cristogg/TESS-W/docs/tesswpcbv1.gif

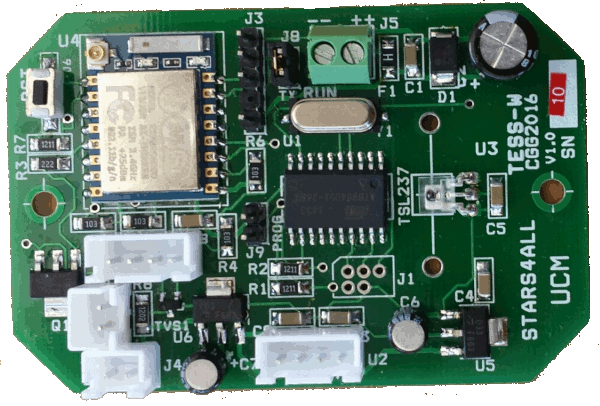
docs/tesswpcbv1.gif
