cristogg/TESS-W/docs/Tess-w_description.jpg

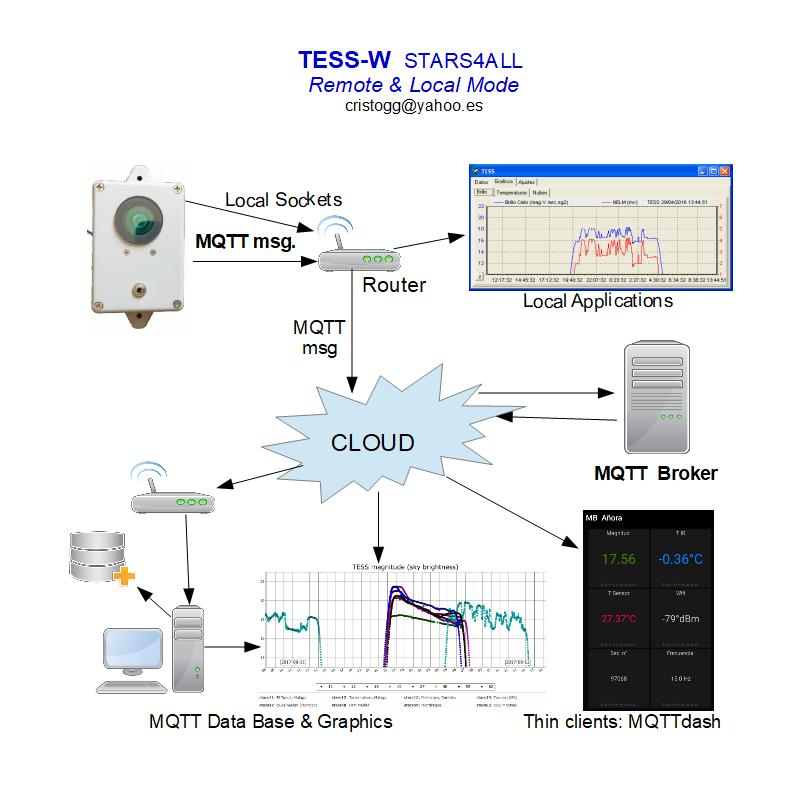
docs/Tess-w_description.jpg
