cristogg/TESS-W/upgrade/UpgradeFirmwareTessW4C.pdf

TESS-W4C Update Firmware | C. Garcia - Feb 2024

## TESS-W4C Firmware Upgrade

To update the firmware you need a micro or C type USB cable, depending on version., the .bin file and the upload program. It is necessary to open the photometer to connect the USB cable.

1- Remove the cover by unscrewing the top four screws.

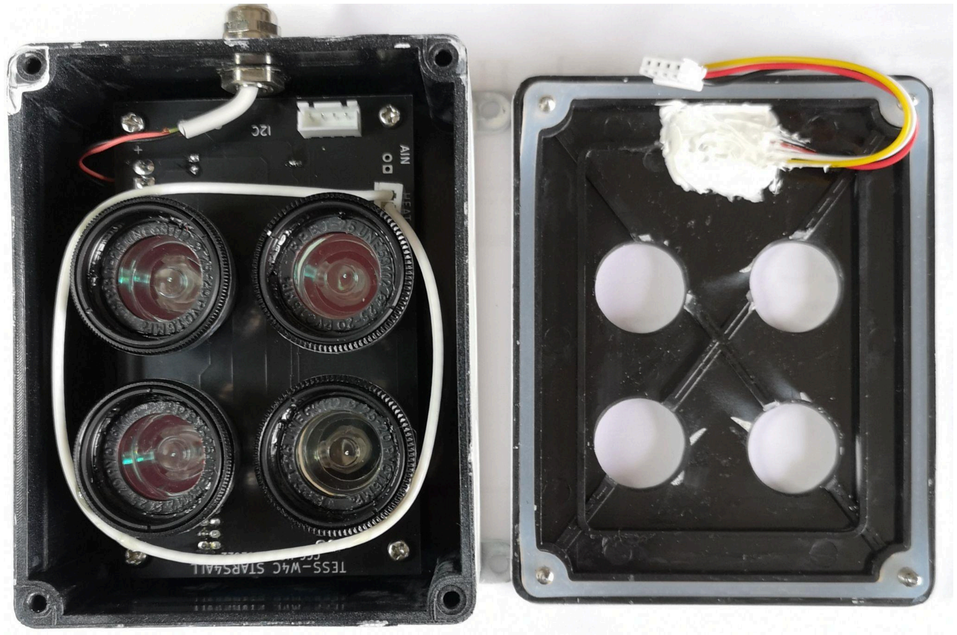
[picture p20: figure]

2- Unscrew the PCB to access the components, and connect the USB cable to the module EP32.

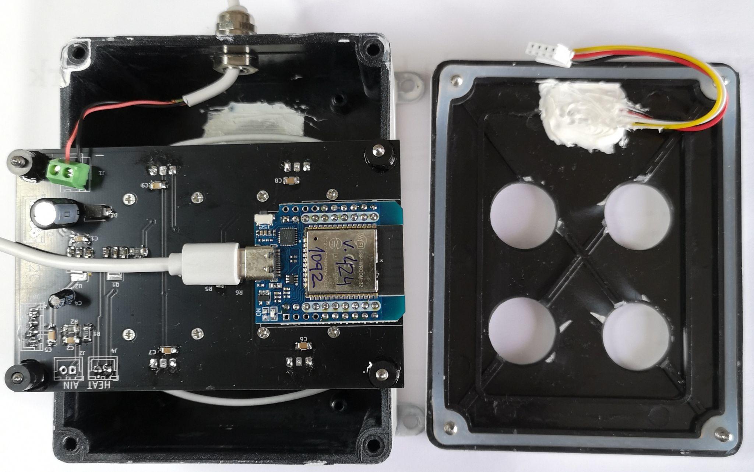
[picture p21: figure]

3- Download and unzip the update package. https://observatorioremoto.com/TessW4C_downloadtool.zip
It contains the update tool, the binary files to be loaded and a small terminal program called Termite for testing.
Before starting the update, use Termite and check how the photometer works. This test is described in the final section.

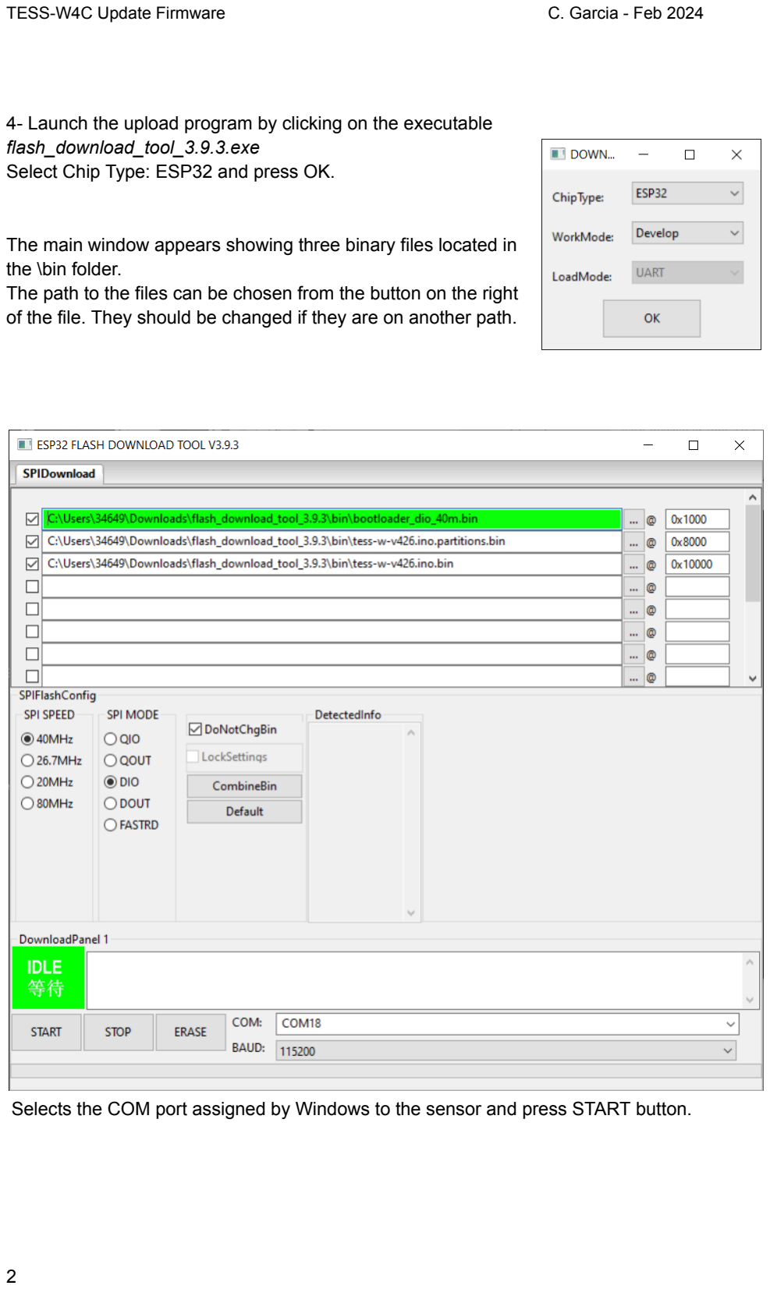
[picture p22: page 2]

4- Launch the upload program by clicking on the executable flash_download_tool_3.9.3.exe
Select Chip Type: ESP32 and press OK.

The main window appears showing three binary files located in the \bin folder.
The path to the files can be chosen from the button on the right of the file. They should be changed if they are on another path.

Selects the COM port assigned by Windows to the sensor and press START button.

5- Final status if all went well.

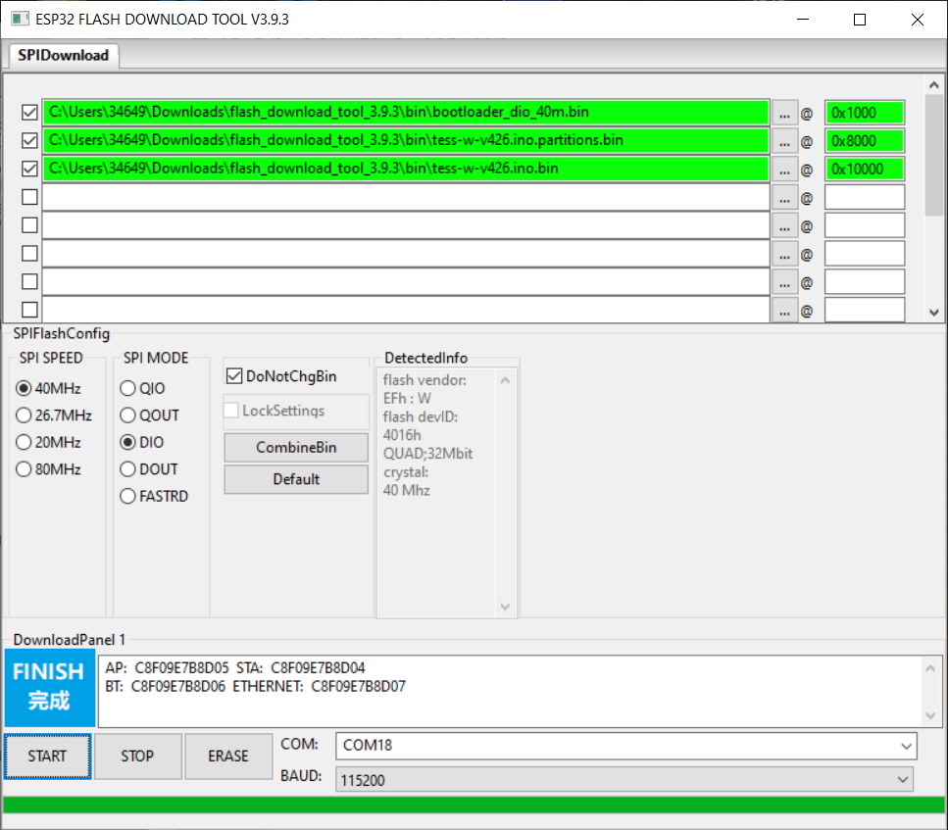
[picture p23: figure]

Close the Download Tool.

Testing TESS-W4C internally.
Using a USB cable to micro or C, we can connect internally to the photometer and with the program Termite.exe observe its operation.

After clicking Termite.exe, go to Settings and select the COM port assigned to your TESS.


It may happen that the first time we connect the photometer, Windows does not find on the internet the driver for the USB to serial adapter of the photometer. Then we have to search for it and download it manually.

To download the driver we first need to know which chip is in our photometer.
With the photometer connected to our PC, open the Device Manager:

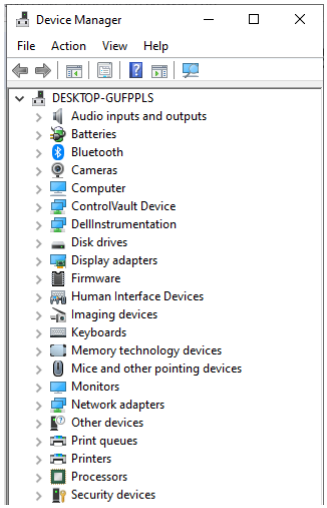
[picture p24: figure]

and cllick on Other devices, it will show the chip installed in Tess. It is for that chip that we need to look for the driver on internet:

Once the USB driver is installed, open Termite, and reset the module by pressing the small button on its board:

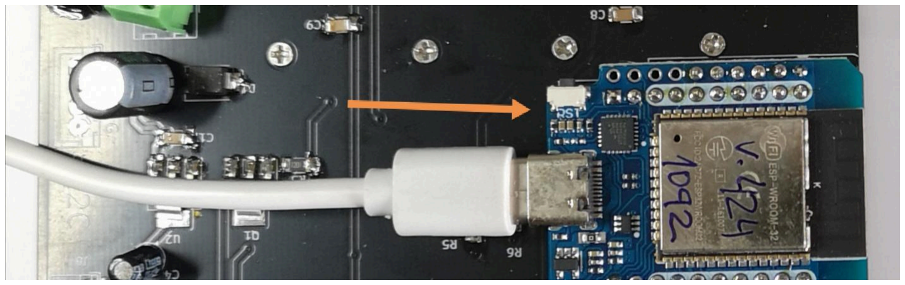
[picture p25: figure]

you will see the Tess sensor configuration, the start of the program and finally the readings. In a module with configuration prior to the update, we can see something like this:

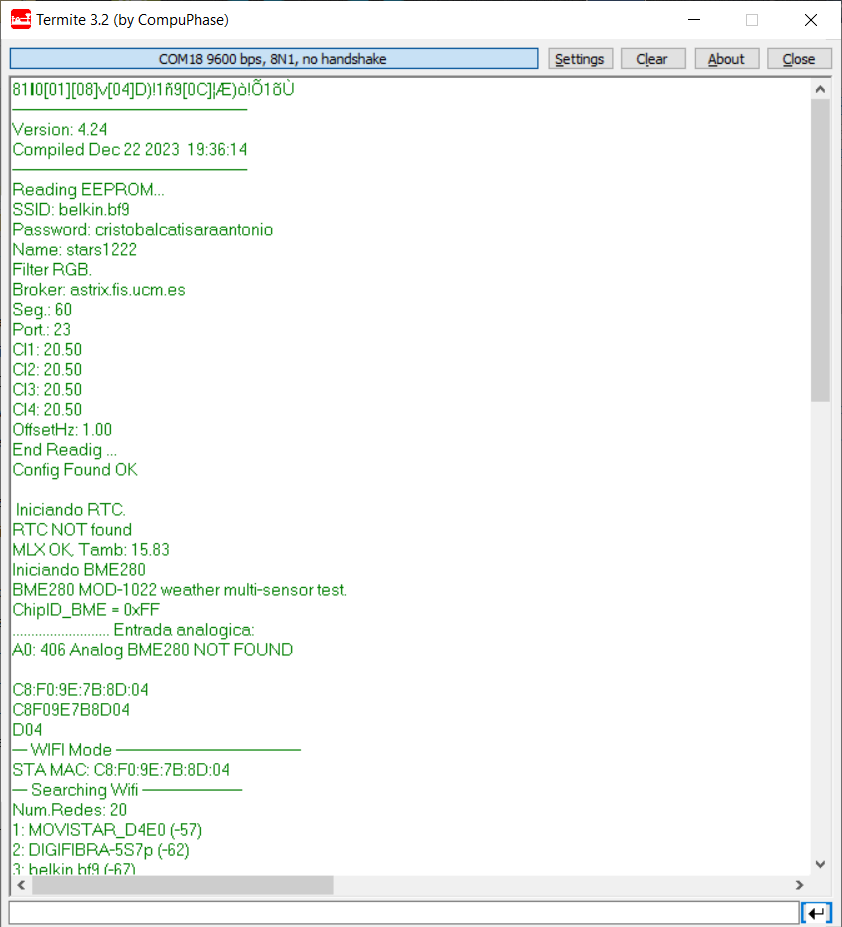
[picture p26: figure]

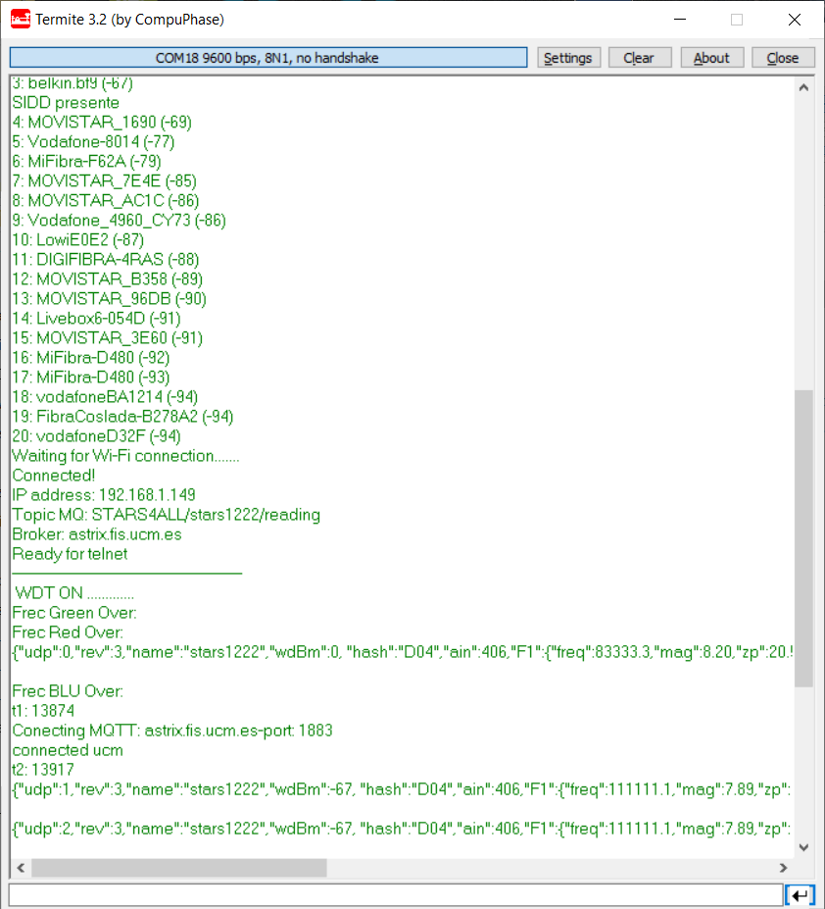
[picture p27: figure]

In order to read the information, we can stop and start the data by clicking on the top bar, which indicates the COM port.

If the TESS had no previous configuration or had been deleted with a Full Reset we will see this:
