cristogg/TESS-W/docs/TessWifiSch.pdf

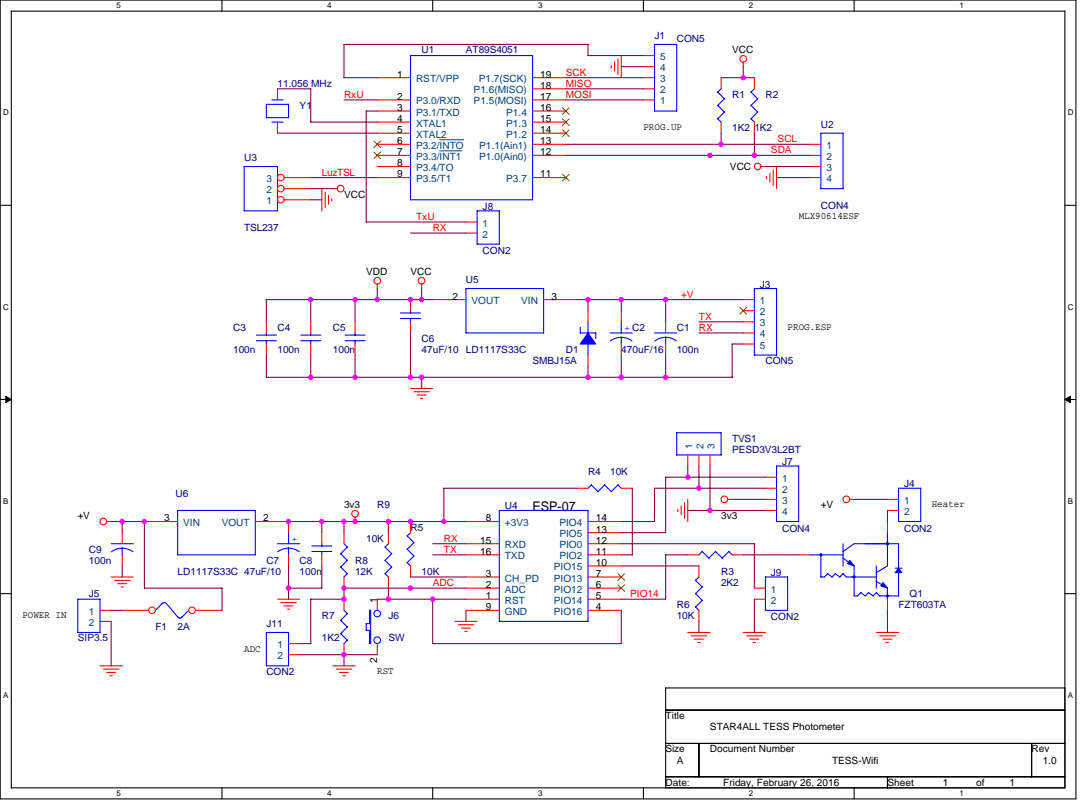
[picture p30: page 1]

J1 CON5

Size A | Document Number TESS-Wifi | Rev 1.0

Date: Friday, February 26, 2016 | Sheet 1 of 1
