cristogg/TESS-W/(commit log)

2026-10-20 Create upgrade-firmware.txt
    The TESS-W firmware upgrade is an exceptional procedure that must be made whenever a serious firmware bug is discovered and it is not practical to return the device to the manufacturer for service.
2026-10-20 Add files via upload
    For upgrade tess pcb version 4.xx
2026-10-20 Add files via upload
    Actualizacíon de TESS-W / TESS-W4C con ESP32. Corresponden a placas versión 4.x.
